kiwinchess/Treuil/captures_ecran/trancannage/doc_chaine.jpg

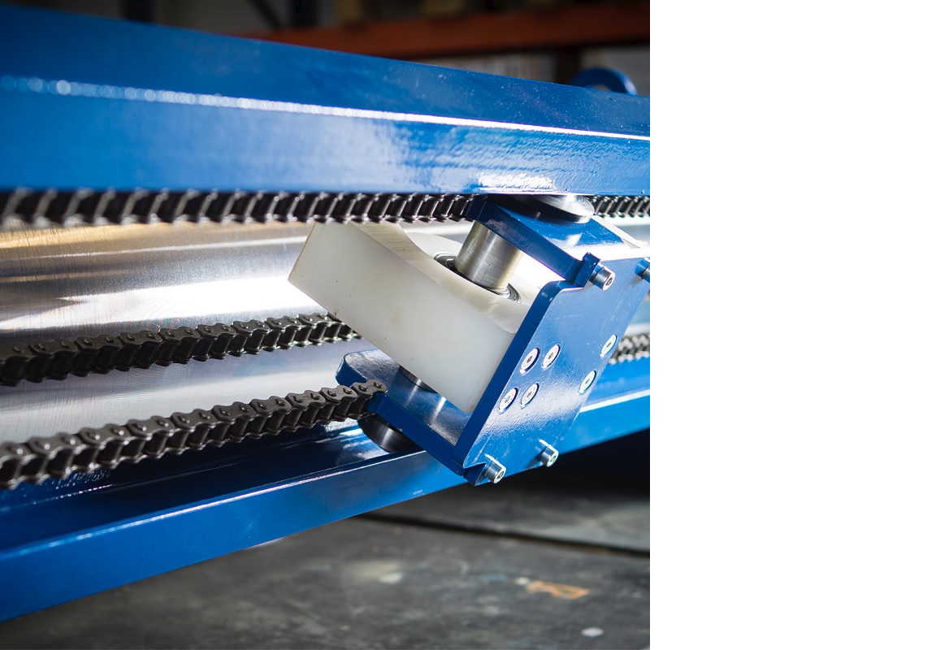
captures_ecran/trancannage/doc_chaine.jpg
