kiwinchess/Treuil/captures_ecran/trancannage/doc_puissance.jpg

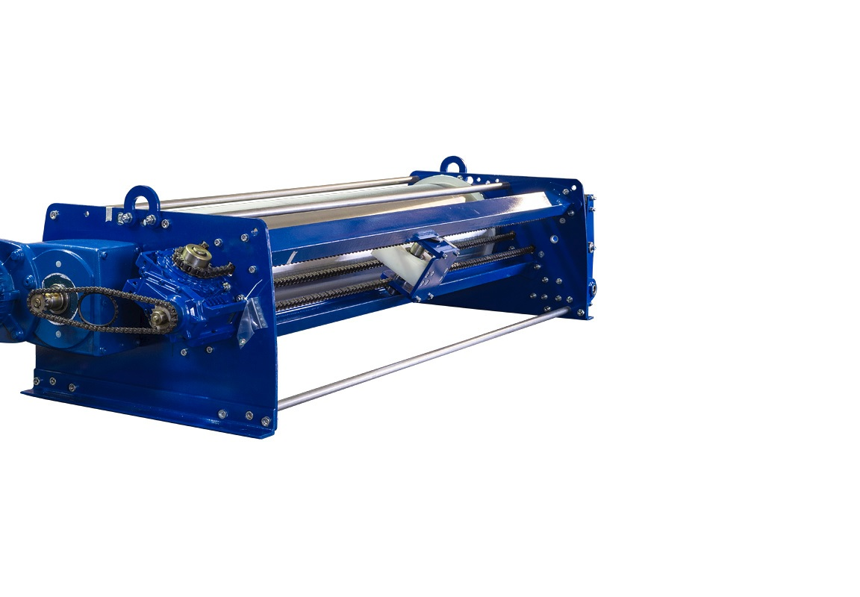
captures_ecran/trancannage/doc_puissance.jpg
