kiwinchess/Treuil/Analysefonctionelle.pptx

## Analyse fonctionnelle

## Slide 2

Hydrographe

Sonar et son câble

Treuil et support

Permettre à l’hydrographe de descendre, tracter, et monter le sonar

## Slide 3

FP: Permettre à l’utilisateur de manœuvrer le sonar
FC1 : Enrouler et dérouler le câble
FC2 : Ne pas détériorer le câble
FC3 : Guider le câble
FC4 : Résister au milieu marin
FC5 : Respecter le milieu marin
FC6 : Recevoir de l’énergie
FC7 : S’adapter au Zodiac
FC8 : S’adapter à l’utilisateur

Milieu marin

FC4,
FC5

Energie

Zodiac

FC6

Treuil et support

FC7

FC8

Utilisateur

FP

FC1,
FC2,
FC3

Sonar et son câble

## Slide 4

| Fonctions | Critères | Niveaux | Flexibilité
Treuil | FP1: Permettre à l’utilisateur de manœuvrer le sonar | Charge temps normal Charge maximale | 1500N 2000N | F0 F0
| FC1 : Enrouler et dérouler le câble | Longueur à enrouler Temps de roulement pour 50m | 50m NA | mini
| FC2 : Ne pas détériorer le câble | Collecteur tournant Rayon de courbure du câble (à fortiori du tambour) pas trop faible
| FC3 : Guider le câble/trancannage | Diamètre du câble Vitesse va-et-vient | 6.3mm Adapté au câble et au treuil | F0
| FC4 : Résister au milieu marin | Corrosion | INOX | F0
| FC5 : Respecter le milieu marin | Pollution
| FC6 : Recevoir de l’énergie | Batterie du Zodiac | 12V | F0
| FC7 : S’adapter au Zodiac | 0m Ordre de la largeur du boudin | mini
| FC8 : S’adapter à l’utilisateur | Distance sonar/CG utilisateur | 0.5m | F3 (d’après les profs.)
