kiwinchess/Treuil/captures_ecran/support.jpg

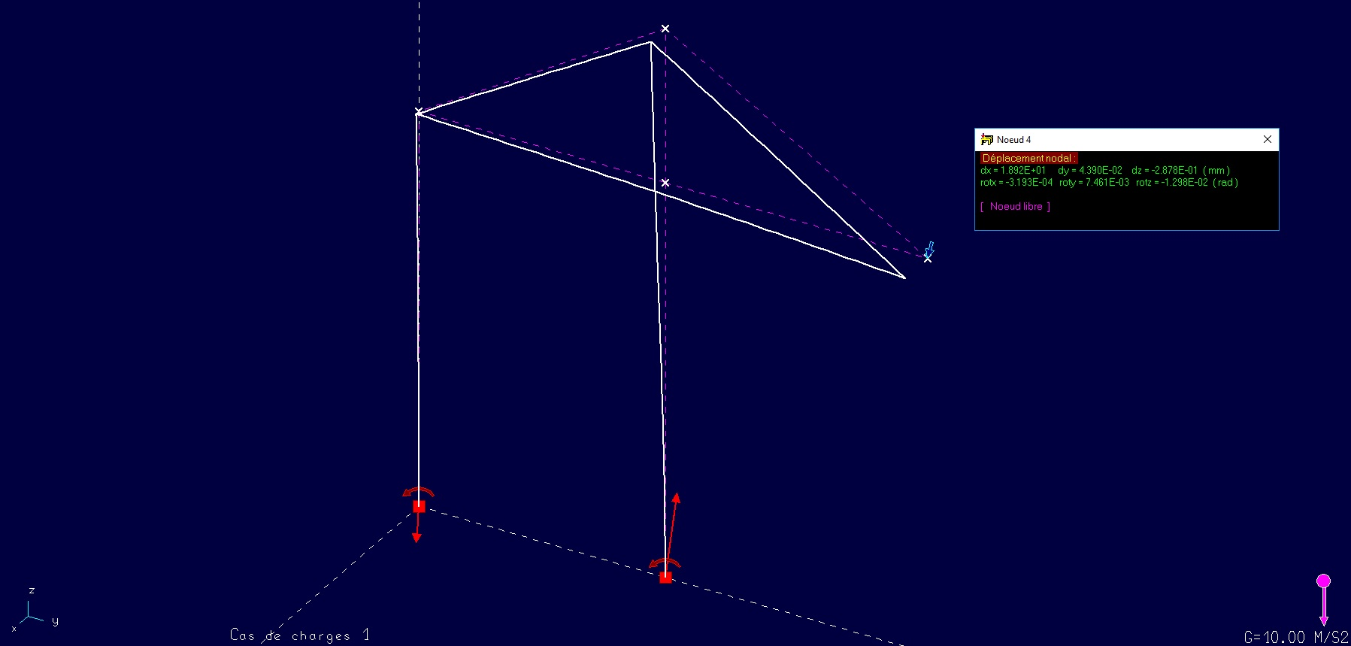
captures_ecran/support.jpg
