kiwinchess/Treuil/captures_ecran/support_accrochage_57deg.jpg

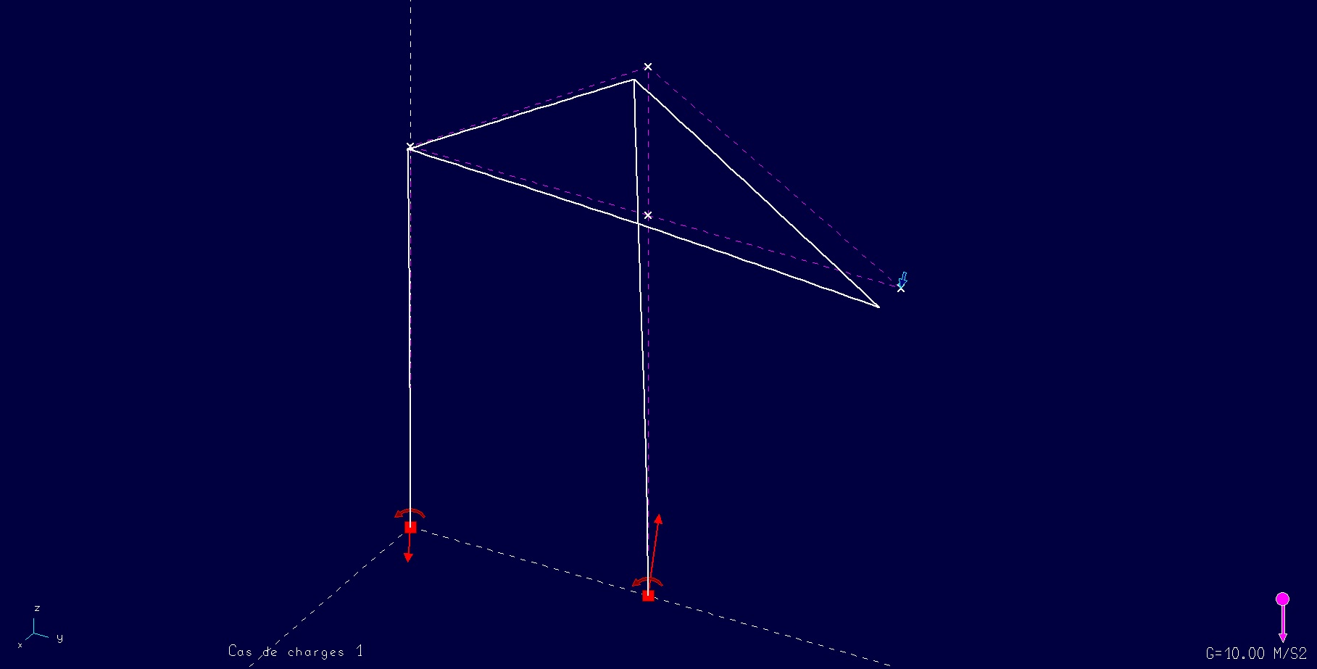
captures_ecran/support_accrochage_57deg.jpg
