kiwinchess/Treuil/captures_ecran/trancannage/chaine.jpg

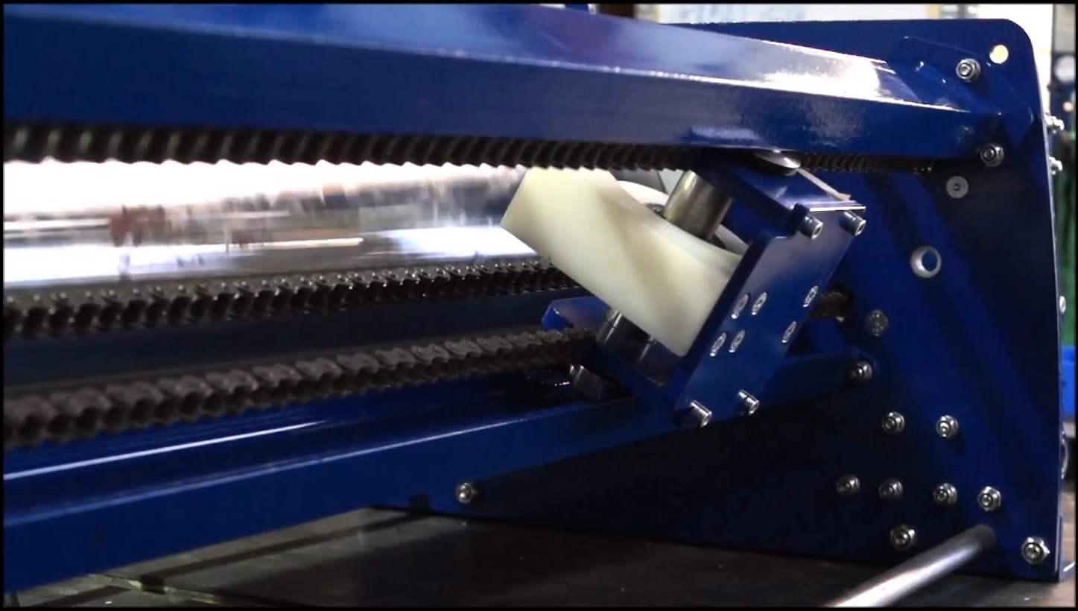
captures_ecran/trancannage/chaine.jpg
