kiwinchess/Treuil/captures_ecran/trancannage/doc_trancannage.jpg

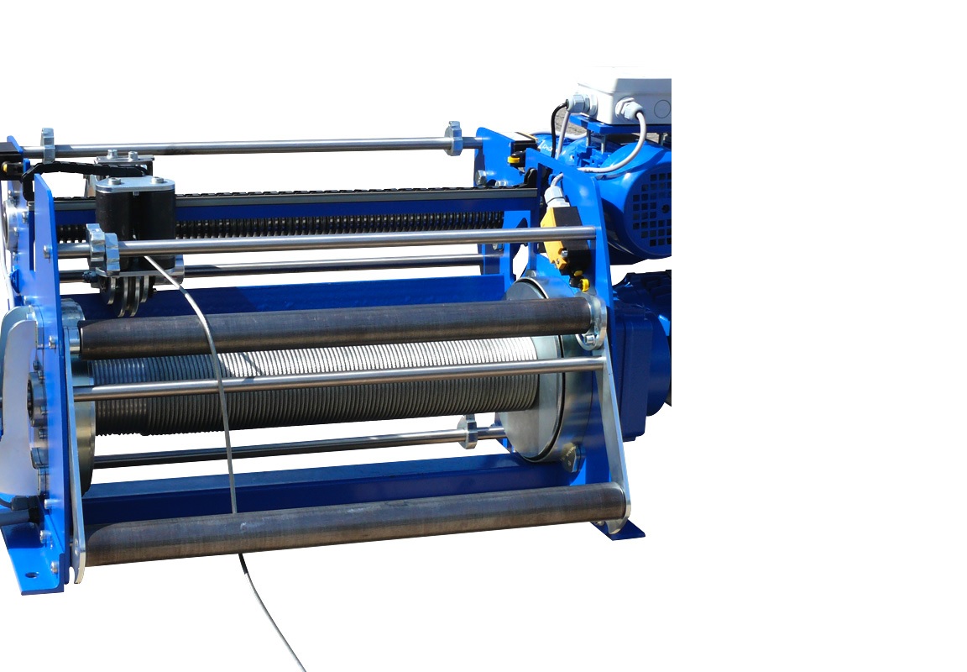
captures_ecran/trancannage/doc_trancannage.jpg
