kiwinchess/Treuil/captures_ecran/trancannage/puissance_trancannage.jpg

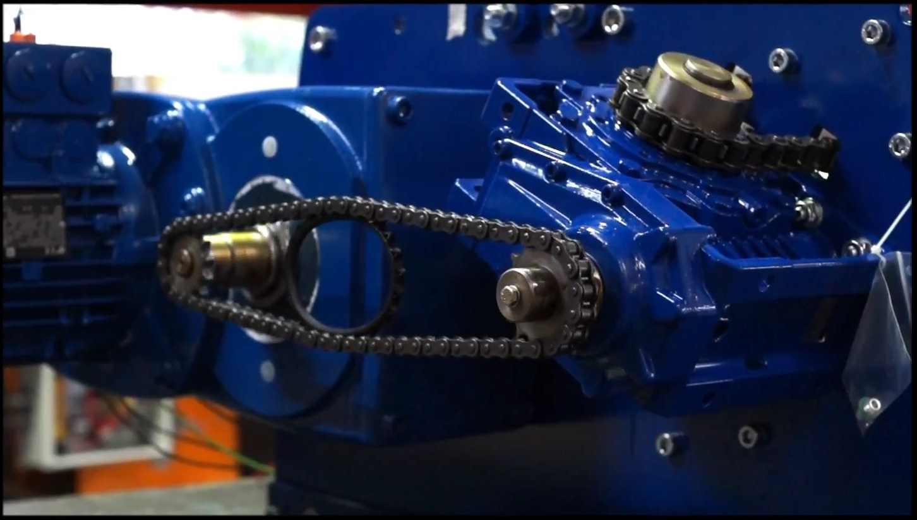
captures_ecran/trancannage/puissance_trancannage.jpg
