kiwinchess/Treuil/captures_ecran/trancannage/trancannage.jpg

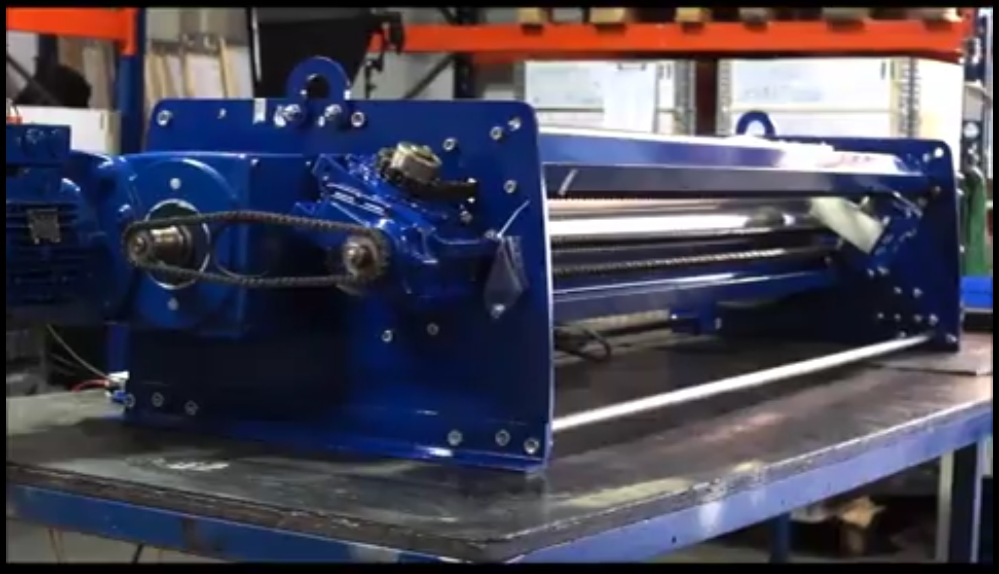
captures_ecran/trancannage/trancannage.jpg
