kiwinchess/Treuil/schema2_v2.png

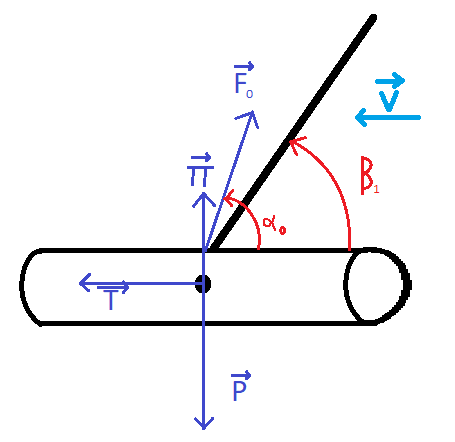
schema2_v2.png
