kiwinchess/Treuil/schema3.png

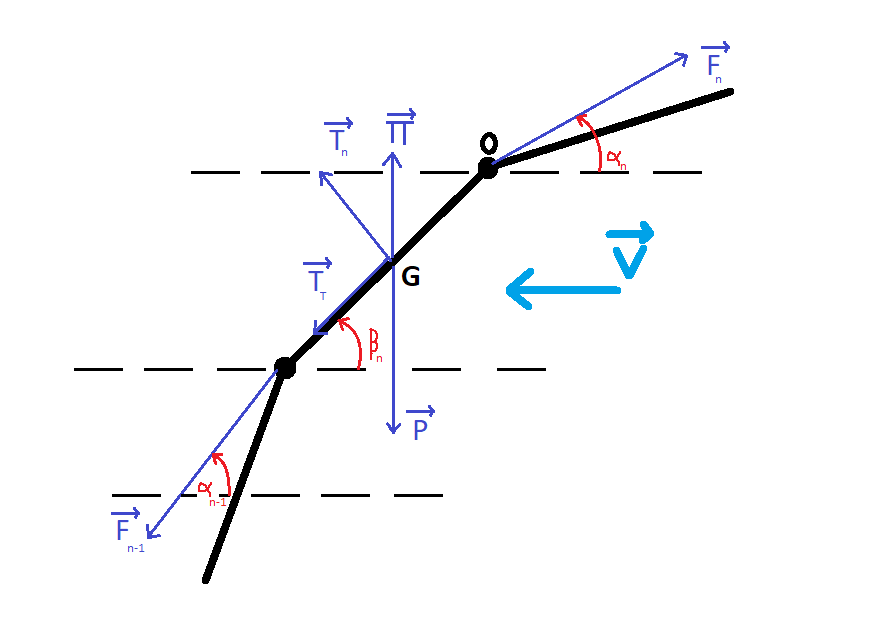
schema3.png
