kiwinchess/Treuil/collecteur/ES6.STEP

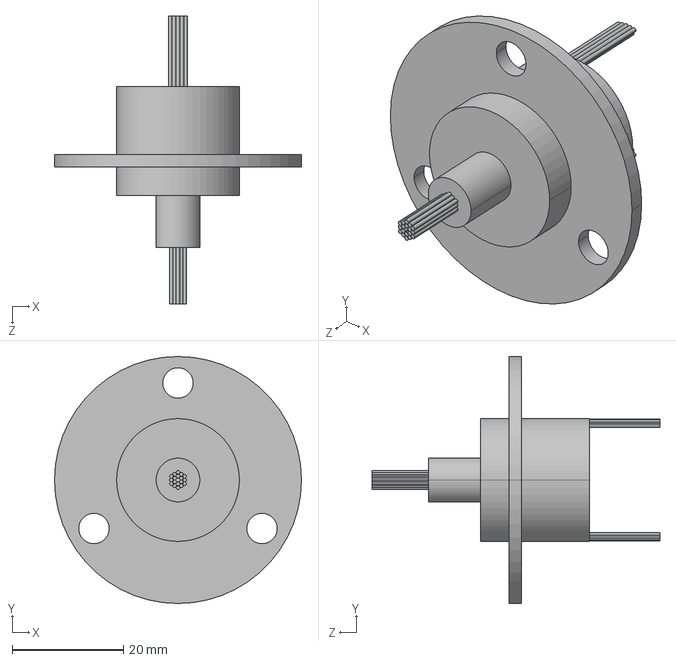
[picture p32: CAD file, 2019-06-13]
collecteur/ES6.STEP
44.4 x 44.4 x 51.8 mm
