kiwinchess/Treuil/fourche/21-020-34-400.stp

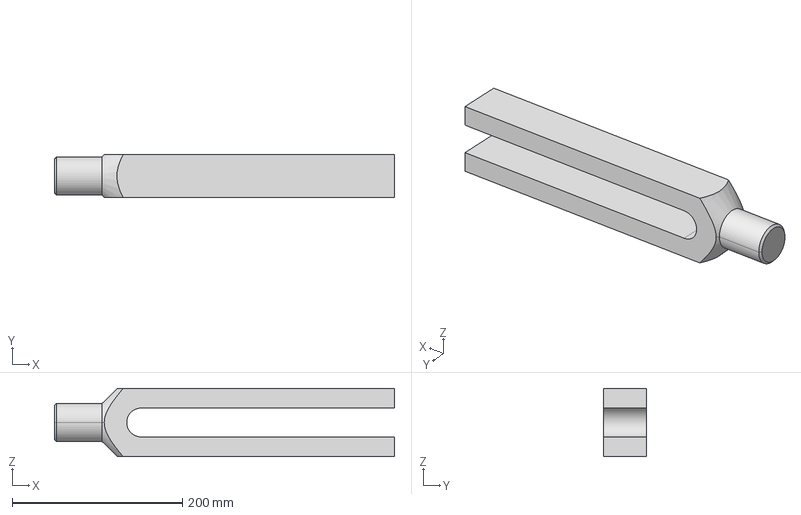
[picture p33: CAD file, 2019-06-19]
fourche/21-020-34-400.stp
400.0 x 50.0 x 80.0 mm
