kiwinchess/Treuil/planeta_pfw0500_v15_dt2-tgl-ltr160_bz1ya5a6iuyavx9qjsum5chqh.stp

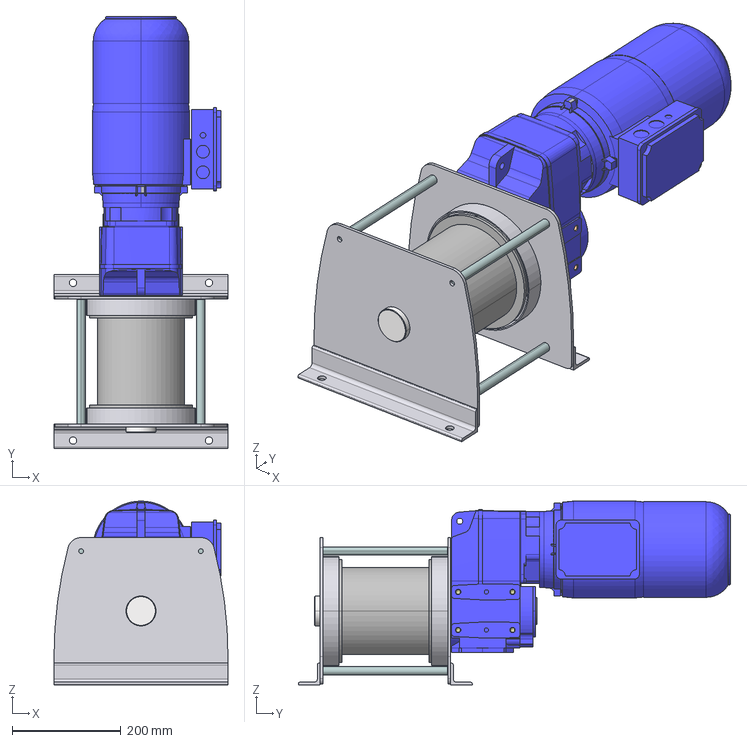
[picture p34: CAD file, 2019-06-17]
planeta_pfw0500_v15_dt2-tgl-ltr160_bz1ya5a6iuyavx9qjsum5chqh.stp
320.0 x 795.2 x 338.1 mm
