kiwinchess/Treuil/Treuils/3-treuil.stp

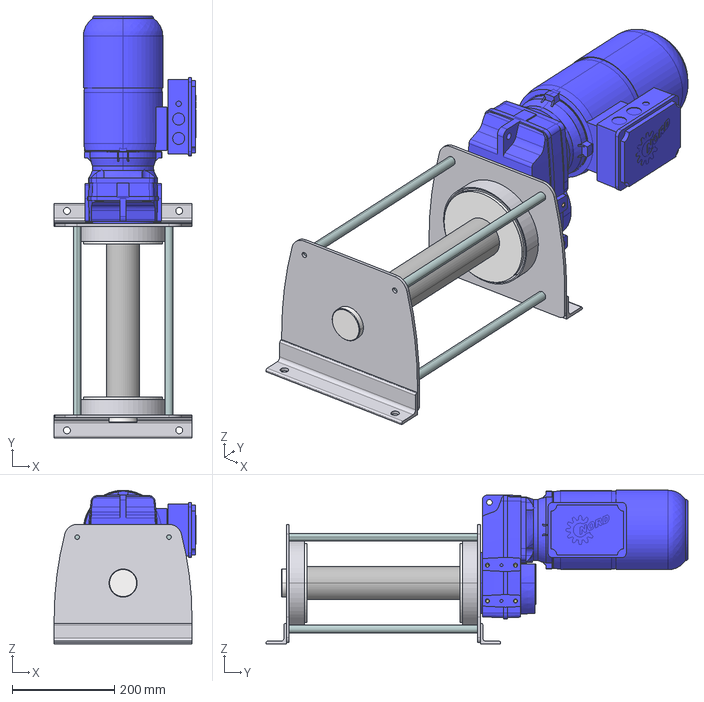
[picture p35: CAD file, 2019-06-13]
Treuils/3-treuil.stp
277.5 x 827.1 x 300.9 mm
