kiwinchess/Treuil/fourche/din_6315_b-40x400.stp

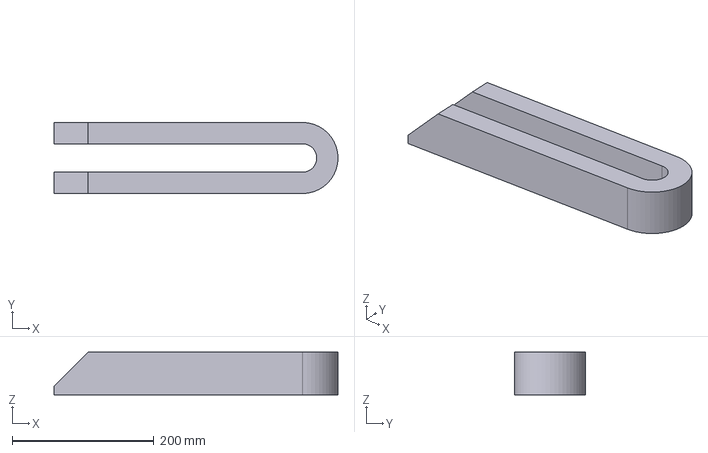
[picture p36: CAD file, 2019-06-19]
fourche/din_6315_b-40x400.stp
400.0 x 100.0 x 60.0 mm
