kiwinchess/Treuil/(list of files, cad)

Other CAD files:
Treuils/2-treuil.stp
Treuils/1-treuil.stp
CAO_Zodiac/BatteryBox.CATPart
CAO_Zodiac/F50D_ETL_3D_ATTACHEMENT.CATPart
CAO_Zodiac/Zodiac_Futura_MIII.CATProduct
CAO_Zodiac/Zodiac_Futura_Prop_1.CATPart
CAO_Zodiac/Zodiac_Seat_A2_1.CATPart
ES6.CATPart
Plaque.CATPart
Support.CATProduct
Treuil.CATPart
Treuil_collecteur.CATProduct
Treuils/treuil_dim.CATPart
U_bolt_1.CATPart
U_bolt_2.CATPart
fourche.CATPart
fourche/21-020-34-400.CATPart
fourche/din_6315_b-40x400.CATPart
fourche/fourche.CATPart
fourche/fourche_bride.CATProduct
pieces_support/1_4.CATPart
pieces_support/1_5.CATPart
pieces_support/1_7.CATPart
pieces_support/2_3.CATPart
pieces_support/2_7.CATPart
pieces_support/4_6.CATPart
pieces_support/4_7.CATPart
trancannage.CATPart
zodiac_term.CATProduct
