kiwinchess/Treuil/Treuils/GlobalResults.htm

# Résultats Globaux

Rapportez produit dessus jeudi, 13 juin 2019 à 11:20:58.

Emplacement du document | : Fichier

Résultats globaux du Checker

V4ToV5Migration

Liste des options de migration____________________________________
___Version de CATIA : V5 V5-6R2017 SP 4___________________________
___Mode défini par l'utilisateur__________________________________
___LAYER : Migration en tant que spécifications___________________
___SET : Migration en tant que spécifications_____________________
___SOLID : Migration en tant que spécifications___________________
___DRAW : Migration en tant que spécifications____________________
___Mode de conversion : non disponible____________________________
___Pas d'élément de structuration_________________________________
___Répertoire de sortie = U:\Documents\Projet2.4\_________________
___Migration des solides polyédriques isolés en tant que CGR______
planeta_pfw0500_v15_dt2-tgl-ltr160_bz1ya5a6iuyavx9qjsum5chqh.model OK
___planeta_pfw0500_v15_dt2-tgl-ltr160_bz1ya5a6iuyavx9qjsum5chqh___

V4ToV5Migration Successfully processed

Batch correctement exécuté - Code de Retour= 0
